kavisha725/processor_fpga_implementation/COMBINED MATLAB/MATLAB ACCESS CODES/frog.jpeg

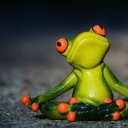
COMBINED MATLAB/MATLAB ACCESS CODES/frog.jpeg
