kavisha725/processor_fpga_implementation/COMBINED MATLAB/MATLAB ACCESS CODES/tiger5_ds.png

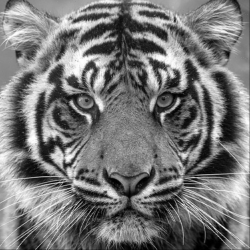
COMBINED MATLAB/MATLAB ACCESS CODES/tiger5_ds.png
