kavisha725/processor_fpga_implementation/COMBINED MATLAB/MATLAB ACCESS CODES/511x511_execution_time.PNG

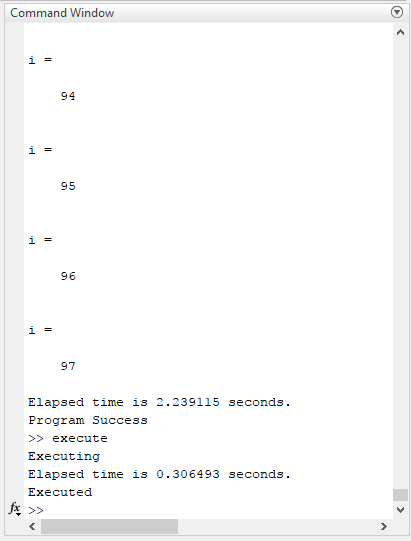
COMBINED MATLAB/MATLAB ACCESS CODES/511x511_execution_time.PNG
