kavisha725/processor_fpga_implementation/COMBINED MATLAB/MATLAB ACCESS CODES/512_error.PNG

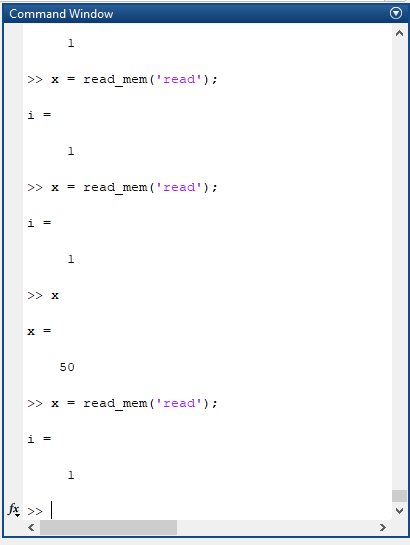
COMBINED MATLAB/MATLAB ACCESS CODES/512_error.PNG
