kavisha725/processor_fpga_implementation/COMBINED MATLAB/MATLAB ACCESS CODES/512x512_execution_time_new.PNG

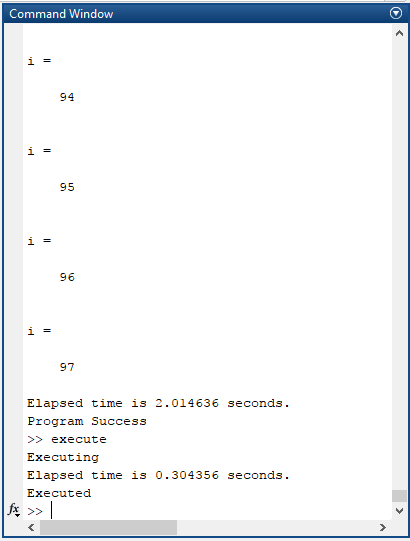
COMBINED MATLAB/MATLAB ACCESS CODES/512x512_execution_time_new.PNG
