kavisha725/processor_fpga_implementation/COMBINED MATLAB/MATLAB ACCESS CODES/512x512_load_time.PNG

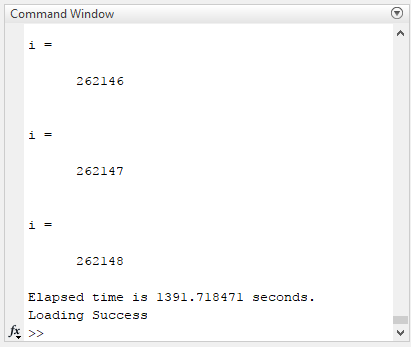
COMBINED MATLAB/MATLAB ACCESS CODES/512x512_load_time.PNG
