kavisha725/processor_fpga_implementation/COMBINED MATLAB/MATLAB ACCESS CODES/bear300_300.jpg

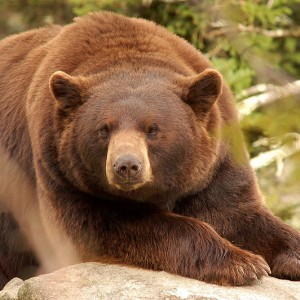
COMBINED MATLAB/MATLAB ACCESS CODES/bear300_300.jpg
