kavisha725/processor_fpga_implementation/COMBINED MATLAB/MATLAB ACCESS CODES/f256_ds.png

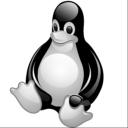
COMBINED MATLAB/MATLAB ACCESS CODES/f256_ds.png
