kavisha725/processor_fpga_implementation/COMBINED MATLAB/MATLAB ACCESS CODES/Fpga4.png

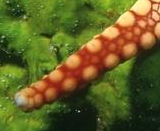
COMBINED MATLAB/MATLAB ACCESS CODES/Fpga4.png
