kavisha725/processor_fpga_implementation/COMBINED MATLAB/MATLAB ACCESS CODES/fpga6_512.png

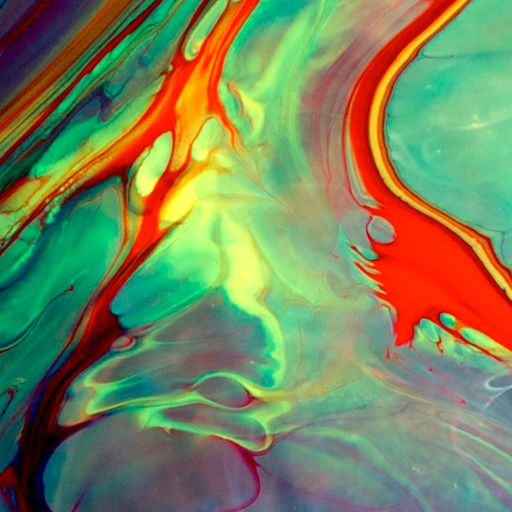
COMBINED MATLAB/MATLAB ACCESS CODES/fpga6_512.png
