kavisha725/processor_fpga_implementation/COMBINED MATLAB/MATLAB ACCESS CODES/Fpga128.png

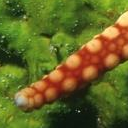
COMBINED MATLAB/MATLAB ACCESS CODES/Fpga128.png
