kavisha725/processor_fpga_implementation/COMBINED MATLAB/MATLAB ACCESS CODES/lion4_ds.png

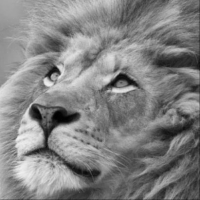
COMBINED MATLAB/MATLAB ACCESS CODES/lion4_ds.png
