kavisha725/processor_fpga_implementation/COMBINED MATLAB/MATLAB ACCESS CODES/output_processed.tif

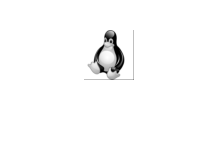
COMBINED MATLAB/MATLAB ACCESS CODES/output_processed.tif
