kavisha725/processor_fpga_implementation/COMBINED MATLAB/MATLAB ACCESS CODES/owl.jpg

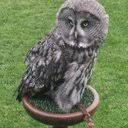
COMBINED MATLAB/MATLAB ACCESS CODES/owl.jpg
