kavisha725/processor_fpga_implementation/COMBINED MATLAB/MATLAB ACCESS CODES/pup2.jpg

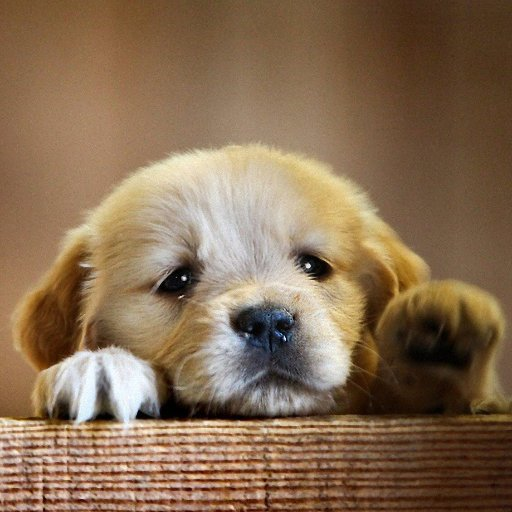
COMBINED MATLAB/MATLAB ACCESS CODES/pup2.jpg
