kavisha725/processor_fpga_implementation/COMBINED MATLAB/MATLAB ACCESS CODES/wolf.jpg

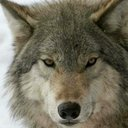
COMBINED MATLAB/MATLAB ACCESS CODES/wolf.jpg
