kavisha725/processor_fpga_implementation/(list of files, cad)

Other CAD files:
DownSample_Cache_added_ddr/DownSample_single_high_mem/simulation/modelsim/rtl_work/@a@l@u/verilog.psm
DownSample_Cache_added_ddr/DownSample_single_high_mem/simulation/modelsim/rtl_work/@amux/verilog.psm
DownSample_Cache_added_ddr/DownSample_single_high_mem/simulation/modelsim/rtl_work/@bmux/verilog.psm
DownSample_Cache_added_ddr/DownSample_single_high_mem/simulation/modelsim/rtl_work/@u@a@r@t_@f@s@m/verilog.psm
DownSample_Cache_added_ddr/DownSample_single_high_mem/simulation/modelsim/rtl_work/baud_rate_gen/verilog.psm
DownSample_Cache_added_ddr/DownSample_single_high_mem/simulation/modelsim/rtl_work/control_unit/verilog.psm
DownSample_Cache_added_ddr/DownSample_single_high_mem/simulation/modelsim/rtl_work/datapath/verilog.psm
DownSample_Cache_added_ddr/DownSample_single_high_mem/simulation/modelsim/rtl_work/img_in_ddr/verilog.psm
DownSample_Cache_added_ddr/DownSample_single_high_mem/simulation/modelsim/rtl_work/img_in_ddr_tb/verilog.psm
DownSample_Cache_added_ddr/DownSample_single_high_mem/simulation/modelsim/rtl_work/ins_ram/verilog.psm
DownSample_Cache_added_ddr/DownSample_single_high_mem/simulation/modelsim/rtl_work/ins_ram_tb/verilog.psm
DownSample_Cache_added_ddr/DownSample_single_high_mem/simulation/modelsim/rtl_work/memory_unit/verilog.psm
DownSample_Cache_added_ddr/DownSample_single_high_mem/simulation/modelsim/rtl_work/processor/verilog.psm
DownSample_Cache_added_ddr/DownSample_single_high_mem/simulation/modelsim/rtl_work/receiver/verilog.psm
DownSample_Cache_added_ddr/DownSample_single_high_mem/simulation/modelsim/rtl_work/register12/verilog.psm
DownSample_Cache_added_ddr/DownSample_single_high_mem/simulation/modelsim/rtl_work/register19/verilog.psm
DownSample_Cache_added_ddr/DownSample_single_high_mem/simulation/modelsim/rtl_work/register@a@c/verilog.psm
DownSample_Cache_added_ddr/DownSample_single_high_mem/simulation/modelsim/rtl_work/register@i@r/verilog.psm
DownSample_Cache_added_ddr/DownSample_single_high_mem/simulation/modelsim/rtl_work/register@p@c/verilog.psm
DownSample_Cache_added_ddr/DownSample_single_high_mem/simulation/modelsim/rtl_work/top_mod/verilog.psm
DownSample_Cache_added_ddr/DownSample_single_high_mem/simulation/modelsim/rtl_work/transmitter/verilog.psm
DownSample_Cache_added_ddr/DownSample_single_high_mem/simulation/modelsim/rtl_work/uart/verilog.psm
ddr w_o cache/DownSample_single_high_mem_v6_DDR_re/simulation/modelsim/rtl_work/@a@l@u/verilog.psm
ddr w_o cache/DownSample_single_high_mem_v6_DDR_re/simulation/modelsim/rtl_work/@amux/verilog.psm
ddr w_o cache/DownSample_single_high_mem_v6_DDR_re/simulation/modelsim/rtl_work/@bmux/verilog.psm
ddr w_o cache/DownSample_single_high_mem_v6_DDR_re/simulation/modelsim/rtl_work/@u@a@r@t_@f@s@m/verilog.psm
ddr w_o cache/DownSample_single_high_mem_v6_DDR_re/simulation/modelsim/rtl_work/baud_rate_gen/verilog.psm
ddr w_o cache/DownSample_single_high_mem_v6_DDR_re/simulation/modelsim/rtl_work/control_unit/verilog.psm
ddr w_o cache/DownSample_single_high_mem_v6_DDR_re/simulation/modelsim/rtl_work/datapath/verilog.psm
ddr w_o cache/DownSample_single_high_mem_v6_DDR_re/simulation/modelsim/rtl_work/img_in_ddr/verilog.psm
ddr w_o cache/DownSample_single_high_mem_v6_DDR_re/simulation/modelsim/rtl_work/img_in_ddr_tb/verilog.psm
ddr w_o cache/DownSample_single_high_mem_v6_DDR_re/simulation/modelsim/rtl_work/ins_ram/verilog.psm
ddr w_o cache/DownSample_single_high_mem_v6_DDR_re/simulation/modelsim/rtl_work/ins_ram_tb/verilog.psm
ddr w_o cache/DownSample_single_high_mem_v6_DDR_re/simulation/modelsim/rtl_work/memory_unit/verilog.psm
ddr w_o cache/DownSample_single_high_mem_v6_DDR_re/simulation/modelsim/rtl_work/processor/verilog.psm
ddr w_o cache/DownSample_single_high_mem_v6_DDR_re/simulation/modelsim/rtl_work/receiver/verilog.psm
ddr w_o cache/DownSample_single_high_mem_v6_DDR_re/simulation/modelsim/rtl_work/register12/verilog.psm
ddr w_o cache/DownSample_single_high_mem_v6_DDR_re/simulation/modelsim/rtl_work/register19/verilog.psm
ddr w_o cache/DownSample_single_high_mem_v6_DDR_re/simulation/modelsim/rtl_work/register@a@c/verilog.psm
ddr w_o cache/DownSample_single_high_mem_v6_DDR_re/simulation/modelsim/rtl_work/register@i@r/verilog.psm
ddr w_o cache/DownSample_single_high_mem_v6_DDR_re/simulation/modelsim/rtl_work/register@p@c/verilog.psm
ddr w_o cache/DownSample_single_high_mem_v6_DDR_re/simulation/modelsim/rtl_work/top_mod/verilog.psm
ddr w_o cache/DownSample_single_high_mem_v6_DDR_re/simulation/modelsim/rtl_work/transmitter/verilog.psm
ddr w_o cache/DownSample_single_high_mem_v6_DDR_re/simulation/modelsim/rtl_work/uart/verilog.psm
