kavisha725/processor_fpga_implementation/DownSample_Cache_added_ddr/DownSample_single_high_mem/simulation/modelsim/rtl_work/register19/_primary.vhd

library verilog;
use verilog.vl_types.all;
entity register19 is
    port(
        clk             : in     vl_logic;
        load            : in     vl_logic;
        clear           : in     vl_logic;
        data_in         : in     vl_logic_vector(18 downto 0);
        data_out        : out    vl_logic_vector(18 downto 0)
    );
end register19;
