kavisha725/processor_fpga_implementation/DownSample_Cache_added_ddr/DownSample_single_high_mem/simulation/modelsim/rtl_work/register@i@r/_primary.vhd

library verilog;
use verilog.vl_types.all;
entity registerIR is
    port(
        clk             : in     vl_logic;
        load            : in     vl_logic;
        clear           : in     vl_logic;
        pass            : in     vl_logic;
        data_in         : in     vl_logic_vector(7 downto 0);
        data_out        : out    vl_logic_vector(7 downto 0)
    );
end registerIR;
